StevenLie14/IoT/README.md

# IoT Project: kode lengkap

Paket ini berisi semua kode untuk Assignment 2 dan tahap AI (AOL):

```
iot/
├─ firmware/iot_project/    Firmware ESP32 (sensor, skor, aturan otomatis, MQTT)
│   ├─ iot_project.ino
│   ├─ config.h             SEMUA pengaturan dan kalibrasi ada di sini
│   └─ secrets.example.h    Template Wi-Fi (salin ke secrets.h, tidak di-commit)
├─ server/                  Next.js full-stack (React + API): MQTT -> PostgreSQL, dashboard, ekspor CSV
│   ├─ app/                 Halaman (dashboard, login) dan API (app/api/*/route.ts)
│   ├─ components/          Komponen React (Dashboard, LoginForm)
│   ├─ lib/                 Database, MQTT ingest, login
│   └─ instrumentation.ts   Menyalakan koneksi MQTT dan database saat server start
├─ nodered/                 Dashboard Node-RED (Dashboard 2.0) dari topik MQTT yang sama
└─ ml/                      Machine learning (Python)
    ├─ water_quality_models.ipynb  EDA, cleaning, perbandingan 7 model
    └─ export_tree.py              Mengubah Random Forest dari notebook jadi water_model.h untuk ESP32
```

## Kesesuaian dengan aturan tugas

| Persyaratan | Di kode |
|---|---|
| ESP32, minimal 3 sensor | DS18B20 (suhu), TDS, turbidity, float switch atas dan bawah |
| Minimal 2 aktuator, rule-based | Pompa buang dan pompa isi (relay), buzzer, dan OLED. Aturan R1 (skor < 60 lima kali berturut-turut, ±15 detik → buzzer 3 beep, pompa buang nyala), R2 (float bawah → berhenti buang, isi sampai float atas), R3 (float atas → selesai, cooldown 30 menit). Pengaman: mode otomatis mati saat ESP32 menyala, R1 tidak jalan kalau sinyal turbidity ±0 V, dan pompa yang jalan lebih dari 2 menit tanpa mencapai float dimatikan (fault, buzzer 5 beep, mode otomatis mati) |
| MQTT | `TOPIC_BASE/data` tiap 3 detik, `/event`, `/cmd`, `/status` |
| Penyimpanan terus-menerus | PostgreSQL: tabel `readings` dan `events` |
| Dashboard | Nilai live, status aktuator, grafik riwayat, tombol kontrol, log event. Ada juga dashboard Node-RED di `nodered/` |
| Dataset minimal 1.000 baris | Ekspor CSV dari dashboard. 1.000 baris = sekitar 33 menit logging |
| Model AI terintegrasi, prediksi real-time | Random Forest (10 tree) jalan langsung di ESP32 tiap 3 detik, dikirim sebagai `ml` dan `ml_conf` lewat MQTT |
| Dashboard: prediksi, confidence, tren, aktuator | Kartu "Condition (model)" dengan confidence, grafik "Model prediction" di History, "Last automatic trigger", status pompa. Node-RED punya grup "AI model" yang sama |
| Aktuator dikontrol AI | Aturan R4: model bilang `dirty` (minimal 60% tree setuju) lima kali berturut-turut → buzzer 3 beep, ganti air otomatis. Ini satu-satunya pemicu ganti air otomatis; R1 hanya dipakai kalau firmware di-compile tanpa model |
| Evaluasi dan perbandingan dengan rule-based | Notebook bagian 11: metrik AI (R4) vs rule-based (R1), simulasi trigger pompa, dan uji ketahanan saat tegangan turbidity turun |

## 1. Firmware ESP32

**Library** (Arduino IDE → Library Manager): Adafruit SSD1306, Adafruit GFX, Adafruit BusIO,
Adafruit ADS1X15, OneWire (Paul Stoffregen), DallasTemperature (Miles Burton),
PubSubClient (Nick O'Leary), ArduinoJson (Benoit Blanchon, versi 7).

**Board:** ESP32 Dev Module (core esp32 by Espressif 3.x).

**Langkah:**
1. Buka `firmware/iot_project/iot_project.ino` (folder `iot_project` harus berisi `iot_project.ino`, `config.h` dan `secrets.h`).
2. Salin `secrets.example.h` menjadi `secrets.h`, lalu isi `WIFI_SSID`, `WIFI_PASS`. File ini ada di `.gitignore`, jadi password tidak ikut ter-commit.
   `TOPIC_BASE` di `config.h` boleh dibiarkan, asal sama dengan server.
3. Cek nilai kalibrasi `TURB_V_CLEAR` (tegangan turbidity di air bening). Pompa berhenti di float, jadi tidak ada kalibrasi volume.
   Banyaknya air yang diganti ditentukan oleh jarak float atas ke float bawah.
4. Upload, buka Serial Monitor 115200, akhir baris **Newline**.

**Pin** (sama dengan sketch tes terakhir): OLED/ADS1115 SDA D21, SCL D22 · DS18B20 D4 · daya TDS D13 ·
TDS → ADS A0 · turbidity → pembagi 10k/20k → ADS A1 · relay pompa buang D26, pompa isi D25 · buzzer D33 · float atas D18, float bawah D19 (kabel lain ke GND).
Cek arah float di Serial Monitor: kalau terbalik, ganti `FLOAT_TOP_TRIGGERED_LEVEL` / `FLOAT_BOT_TRIGGERED_LEVEL`.

**Perintah Serial** (juga bisa dari dashboard):
`change` · `stop` · `auto on` / `auto off` · `beep` · `drain 3` · `fill 3`

## 2. Server dan dashboard

Server memakai **PostgreSQL**. Cara paling mudah menjalankan server + database sekaligus adalah Docker:

```bash
cp .env.example .env      # isi DB_PASSWORD dan DASHBOARD_PASSWORD
docker compose up -d --build
```

Buka **http://localhost:7575**. Laptop cukup terhubung internet; tidak harus satu Wi-Fi dengan ESP32.

Tanpa Docker (butuh Node.js 20.9+ dan PostgreSQL yang sudah terpasang):

```bash
cd server
npm install
PGHOST=localhost PGUSER=iot_project PGPASSWORD=... PGDATABASE=iot_project npm run dev
```
Lalu buka http://localhost:3000. Tabel dibuat otomatis saat server pertama kali jalan.
Untuk mode produksi: `npm run build` lalu `npm start`.

Server ini harus berjalan terus (koneksi MQTT selalu tersambung), jadi jalankan di server sendiri
atau Docker, bukan di platform serverless seperti Vercel.

Kalau Wi-Fi kampus memblokir MQTT (port 1883), pakai hotspot HP untuk ESP32 dan laptop.

## 2b. Dashboard Node-RED

Flow di `nodered/flows.json` subscribe ke `TOPIC_BASE/data`, `/status`, dan `/event` di broker.hivemq.com, lalu menampilkan gauge (skor, TDS, turbidity, suhu), status pompa, grafik 1 jam terakhir, grup "AI model" (prediksi, confidence, grafik prediksi, dan trigger otomatis terakhir dari `/event`), dan tombol perintah (ganti air, stop, tes buzzer, mode auto) yang dikirim ke `TOPIC_BASE/cmd`. Firmware tidak perlu diubah, dan bisa jalan bersamaan dengan dashboard Next.js.

Butuh Node.js 18 atau lebih baru:

```bash
cd nodered
npm install
npm start
```

Buka http://localhost:1880/dashboard untuk dashboard, dan http://localhost:1880 untuk editor flow. Kalau `TOPIC_BASE` di `config.h` diganti, ganti juga topiknya di node `data`, `status` dan `cmd`.

Di server, Node-RED ikut di-deploy sebagai container `iot-project-nodered` (port 7576) oleh workflow yang sama. Versi server memakai `settings.prod.js`: login sama dengan dashboard utama (`DASHBOARD_USER` / `DASHBOARD_PASSWORD`), dan editor flow dimatikan, jadi perubahan flow dibuat di laptop lalu di-push. Untuk domainnya, jalankan role nginx di `ansible-infrastructure` dengan `domain_name` baru (misalnya `iot-nodered.stevenlie.site`) dan `frontend_port: 7576`.

## 3. Mengumpulkan dataset

1. Jalankan server, nyalakan ESP32. Titik "ESP32" dan "Live data" di dashboard harus hijau.
2. Biarkan berjalan minimal 33 menit untuk 1.000 baris (kartu **Dataset** menghitungnya).
3. Klik **Download CSV (device)**. File ini yang dilampirkan di laporan.

### Data berlabel untuk ML
Pilih label di kartu **Condition label** sebelum merekam tiap jenis air. Setiap baris baru disimpan dengan label itu.

| Label | Cara membuat air | Lama rekam |
|---|---|---|
| `clear` | air keran bersih | 10–15 menit |
| `slightly_turbid` | beberapa tetes susu atau sedikit tanah | 10–15 menit |
| `dirty` | lebih banyak susu/tanah + sejumput garam | 10–15 menit |

Tips: ulangi tiap kondisi 2–3 kali di waktu berbeda supaya model tidak hanya menghafal satu sesi.
Matikan pompa saat merekam (baris saat pompa jalan otomatis dibuang).

## 4. Machine learning

```bash
cd ml
pip install -r requirements.txt
jupyter notebook water_quality_models.ipynb
```

Taruh CSV hasil export dashboard di `ml/data/`, lalu jalankan semua sel notebook. Isinya: overview data,
cleaning, EDA (time series, distribusi, boxplot, korelasi), split berdasarkan waktu per label (awal untuk latih,
akhir untuk uji, supaya pembacaan yang hampir sama tidak bocor ke data uji), lalu perbandingan Decision Tree,
Random Forest, Gradient Boosting, k-NN, Logistic Regression, SVM, dan Naive Bayes. Semua grafik tersimpan di
`ml/results/` dan semua model di `ml/models/`.

### Model di ESP32 (Random Forest)
Model jalan langsung di ESP32 sehingga tetap bekerja tanpa Wi-Fi:

```bash
cd ml
python export_tree.py --model models/random_forest.joblib
```

Jalankan notebook dulu: bagian akhirnya menyimpan Random Forest kecil (10 tree, kedalaman maksimal 3, fitur `tds`
dan `turb_v`) ke `models/random_forest.joblib`. Skrip ini memuat model itu, mengecek vote ESP32 sama dengan sklearn,
lalu memakai [micromlgen](https://github.com/eloquentarduino/micromlgen) untuk menulis
`firmware/iot_project/water_model.h`: tiap tree jadi `if-else` dan hasilnya di-voting (satu suara per tree). Upload ulang firmware.
ESP32 lalu menampilkan hasilnya di OLED (CLEAR / SLIGHT / DIRTY) dan mengirimnya sebagai field `ml` di data MQTT,
bersama `ml_conf` (bagian tree yang setuju, 0 sampai 1), sehingga muncul di kartu prediksi dan grafik tren pada dashboard
dan tersimpan di kolom `ml` / `ml_conf` database. Kalau mode auto nyala, prediksi `dirty` lima kali berturut-turut
memicu ganti air (aturan R4). Aturan skor R1 tidak dipakai selama model ada; skor tetap dihitung dan ditampilkan.

**Isi CSV dataset** (`/api/export.csv`, hanya data dari ESP32): `timestamp_wib`, `t_tank`, `tds`, `tds_v`, `turb`, `turb_v`, `label`.
Baris saat pompa jalan dan 5 detik sesudahnya tidak ikut diekspor (terganggu gelembung).

Sebelum model dibuat, `water_model.h` berisi placeholder sehingga firmware tetap bisa di-compile.
Latih dan ekspor ulang setiap kali sensor dikalibrasi ulang.

## 5. Deploy dashboard ke server (Docker)

Mengikuti pola repo `stevenlie` dan `serverh1`: GitHub Actions di runner `shin` membangun image,
push ke Harbor, lalu `docker compose up` di server. Nginx + SSL dibuat lewat repo `ansible-infrastructure`.

File yang dipakai: `Dockerfile`, `docker-compose.yml`, `.github/workflows/deploy.yml`.
Ada dua container: `iot-project` (Next.js di Node 26, port **7575**) dan `iot-project-db` (PostgreSQL 17, tidak dibuka ke luar).
Data database tersimpan di volume Docker `iot_project_pg`.

### Langkah sekali saja
1. Kode ada di repo **`StevenLie14/IoT`**. Deploy berjalan saat ada push ke branch `main`.
2. Di `ansible-infrastructure/.env`: set `GITHUB_REPO_URL=https://github.com/StevenLie14/IoT`, lalu jalankan
   `--tags runner` (daftarkan runner `shin` ke repo ini) dan `--tags secret` (REGISTRY_* dan VAULT_*).
3. Di Vault, di path `VAULT_PATH` untuk repo ini, simpan `DB_PASSWORD` dan `DASHBOARD_PASSWORD` (wajib),
   dan opsional `DB_USER`, `DB_NAME`, `DASHBOARD_USER`, `MQTT_URL`, `TOPIC_BASE`.
4. Buat DNS A record, misalnya `iot.stevenlie.site`, ke IP server.
5. Di `ansible-infrastructure/inventory/host_vars/nginx.yml`: `domain_name: "iot.stevenlie.site"`,
   `frontend_port: 7575`, `has_backend: false`, lalu jalankan `--tags nginx`.

Setelah itu setiap push ke `main` otomatis build dan deploy. Buka `https://iot.stevenlie.site`
dan login dengan `DASHBOARD_USER` (bawaan `admin`) dan `DASHBOARD_PASSWORD`.
Halaman login muncul otomatis. Sesi berlaku 7 hari, dan mengganti `DASHBOARD_PASSWORD` membuat semua sesi keluar.
Setelah 10 kali password salah dari satu alamat IP, login dikunci 15 menit.

### Jalankan dengan Docker di komputer sendiri
```bash
cp .env.example .env      # isi DB_PASSWORD dan DASHBOARD_PASSWORD
docker compose up -d --build
```
Buka http://localhost:7575.

**Tanpa `DASHBOARD_PASSWORD`, dashboard tidak punya login dan siapa pun bisa menyalakan pompa.**
Selalu isi password kalau dashboard bisa diakses dari internet.

## Status pengujian

- Server, dashboard, dan aturan otomatis sudah diuji jalan.
- Skrip ML sudah diuji dengan data sintetis untuk memastikan berjalan. Angka akurasi untuk laporan harus dari data asli Anda.
- Image Docker sudah diuji jalan (login, data tetap ada setelah restart, health check).
- Firmware **belum di-compile**; compile dan uji di Arduino IDE Anda.
