StevenLie14/IoT/docs/diagrams/architecture.png

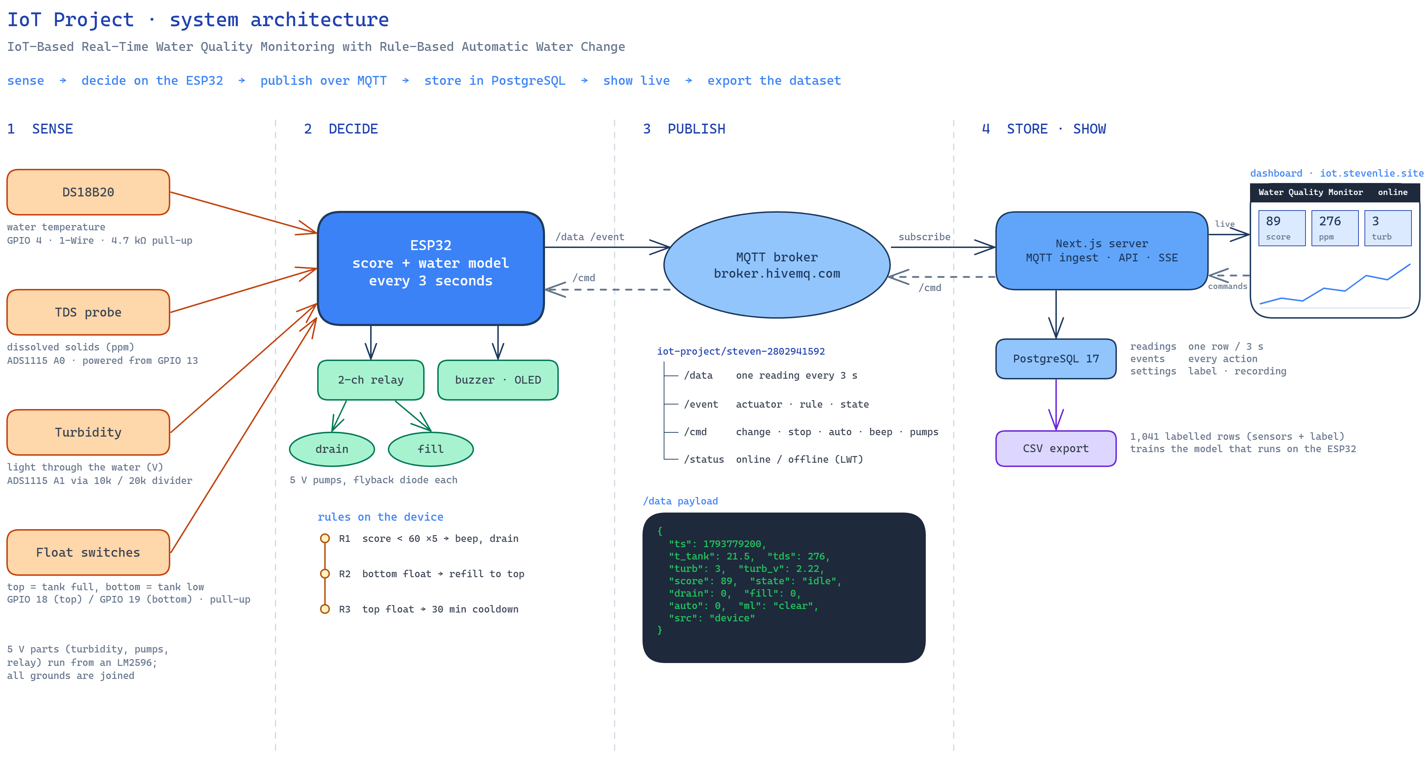
docs/diagrams/architecture.png
