StevenLie14/IoT/docs/diagrams/flowchart.png

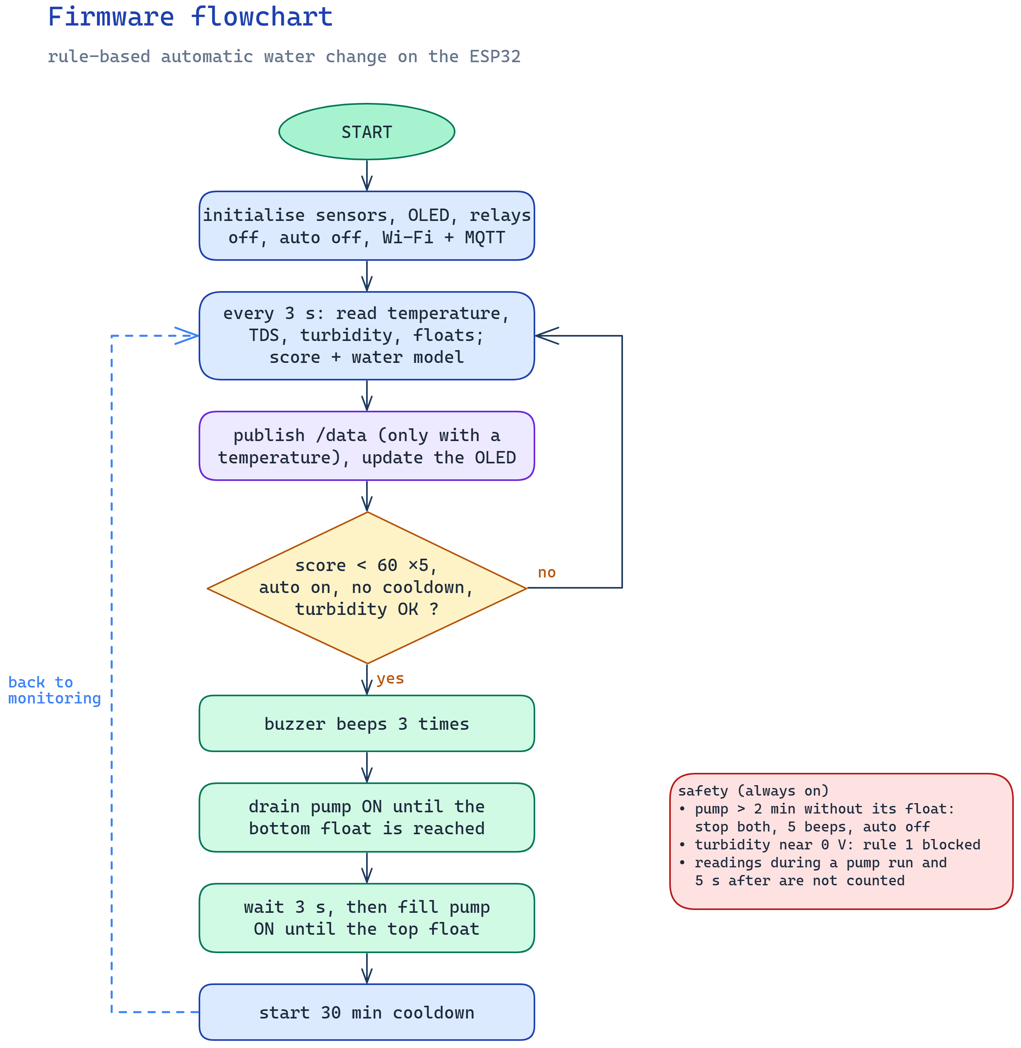
docs/diagrams/flowchart.png
