StevenLie14/IoT/(commit log)

2026-11-02 feat(firmware): add esp32 firmware
2026-11-02 feat(server): add device simulator
2026-11-02 feat(ml): add decision tree export for esp32
2026-11-02 feat(firmware): run water model on device
2026-11-02 feat(server): store device prediction
2026-11-02 feat(dashboard): show device prediction
2026-11-02 docs: add esp32 model guide
2026-11-02 feat(server): switch storage to postgres
2026-11-02 fix(server): track csv export routes
2026-11-02 feat(sim): support pump test commands
2026-11-02 refactor: remove led
2026-11-02 docs: drop ml stage from architecture diagram
2026-11-02 feat(nodered): add node-red dashboard flow
2026-11-02 refactor: remove temperature difference rule
2026-11-02 docs: add firmware flowchart diagram
2026-11-02 refactor: drain and refill by float switches
2026-11-02 feat(firmware): read sensors every 2 s, act after 5 low readings
2026-11-02 refactor: remove ph sensor support
2026-11-02 feat: support private mqtt broker with tls and login
    [config.h, iot_project.ino]
2026-11-03 fix(firmware): hold last temperature on a failed read
    [iot_project.ino]
2026-11-03 fix(firmware): read ds18b20 by address with retries
    [iot_project.ino]
2026-11-03 fix(firmware): calibrate clear-water turbidity voltage to 2.93 v
    [config.h]
2026-11-03 chore(firmware): read sensors every 3 s
2026-11-03 fix(firmware): read temperature while tds power is off
    [iot_project.ino]
2026-11-03 fix(firmware): skip failed temperature reads for up to 60 s
    [config.h, iot_project.ino]
2026-11-03 fix(firmware): alert only after 60 s without a temperature reading
    [iot_project.ino]
2026-11-03 fix(firmware): skip publishing readings without a temperature
    [iot_project.ino]
2026-11-03 feat(firmware): report supply voltage from ads a3
2026-11-03 fix(firmware): recalibrate turbidity to 2.0 v clear and 1.0 v span
    [config.h]
2026-11-03 feat(server): add reset all data button to dashboard
2026-11-03 fix(firmware): debounce float switches and log why manual runs end
    [config.h, iot_project.ino]
2026-11-03 feat(server): show each float switch state on dashboard
2026-11-03 feat(firmware): add pump timeouts, turbidity fault check, auto off at boot
2026-11-03 fix(firmware): swap top and bottom float pins to match wiring
    [config.h]
2026-11-03 fix(firmware): invert float trigger levels to match switches
    [config.h]
2026-11-03 fix(firmware): refuse manual fill when full and drain when low
    [iot_project.ino]
2026-11-03 feat(server): disable test pump buttons at the floats
2026-11-03 feat(server): add drain and fill to float buttons
2026-11-03 fix(firmware): ignore readings for r1 while pumps run and 5 s after
    [config.h, iot_project.ino]
2026-11-03 fix(firmware): recalibrate turbidity to 1.75 v clear and 0.75 v span
    [config.h]
2026-11-03 refactor(server): hide raw sensor voltages on dashboard
2026-11-03 fix(firmware): recalibrate turbidity to 2.25 v clear and 1.25 v span
    [config.h]
2026-11-03 fix(firmware): recalibrate turbidity to 2.25 v clear and 1.0 v span
    [config.h]
2026-11-03 fix(firmware): retry ds18b20 discovery when missing at boot
    [iot_project.ino]
2026-11-03 docs: add short purpose comments to functions
    [iot_project.ino]
2026-11-04 feat(ml): export a 10-tree random forest to the esp32
2026-11-04 feat(server): export only sensors and label in the dataset csv
2026-11-04 feat(firmware): publish on-device model prediction as ml
2026-11-04 docs: update architecture and flowchart diagrams
2026-11-04 feat(firmware): redesign oled with status and pump screens
    [iot_project.ino]
2026-11-04 refactor(ml): notebook reads sensor-only dataset csv
2026-11-04 fix(firmware): recalibrate turbidity to clear 1.75 V and span 0.55 V
    [config.h]
2026-11-04 fix(firmware): add TURB_V_GAIN to scale the turbidity voltage back to the clear-water calibration
    [config.h, iot_project.ino]
2026-11-04 feat: ai-driven control (R4), model confidence, prediction trends and ai vs rule-based evaluation
    - firmware: send ml_conf (share of trees that agree) and add rule R4 that starts a water change after 5 confident dirty predictions
    - export_tree.py: generated header exposes the vote count for the confidence
    - dashboard: confidence on the prediction card, model prediction history chart, last automatic trigger (R1 or R4)
    - node-red: AI model group with prediction, confidence, trend chart and last trigger
    - notebook: section 11 compares the AI rule with the rule-based score rule, incl. a turbidity voltage drop test
2026-11-04 fix(firmware): raise TURB_V_GAIN to 1.94 for the lower clear-water voltage
    [config.h]
2026-11-04 fix(firmware): set TURB_V_GAIN to 1.90
    [config.h]
2026-11-04 fix(firmware): set TURB_V_GAIN back to 1.94
    [config.h]
2026-11-04 revert(firmware): remove TURB_V_GAIN, read the turbidity voltage as is
    [config.h, iot_project.ino]
2026-11-05 refactor: remove private broker support (login, TLS), use the public broker only
    [config.h, iot_project.ino]
2026-11-05 refactor(firmware): remove the USE_FLOATS switch, the float switches are always fitted
2026-11-05 refactor(firmware): remove the supply voltage monitor on ADS A3
2026-11-05 refactor(firmware): drop the temperature hold, a failed DS18B20 read now skips that reading
    [config.h, iot_project.ino]
2026-11-05 refactor(firmware): drop the 5 s quiet time after a pump stops
